kelykokutou/-STM32-/附加文件/大三_实训作业_智能家居控制.xlsx

Comment | Footprint | Quantity | Designator
button | switch_2P | 6 | B1, B2, B3, B4, B5, B6
20pF | 0603 | 2 | C1, C2
10nF | 0603 | 2 | C3, C9
100nF | 0603 | 10 | C4, C5, C6, C7, C11, C12, C13, C14, C15, C16
4.7uF | 0603 | 1 | C8
1uF | 0603 | 1 | C10
100uF | CAP_3.5_8mm | 1 | C17
Diode | SOD_123 | 5 | D1, D2, D3, D4, D5
LED | 0603-led | 4 | D6, D7, D8, D9
7.62_螺丝固定端子 |  | 1 | J6
继电器-5V | relay_5pin | 1 | K1
Header 4 | HDR1X4 | 2 | P1, P2
Header 2 | HDR1X2 | 2 | P3, P4
Header 2 | 2P_螺钉式接线端子_5.08mm | 1 | P5
Header 3 | HDR1X3 | 1 | P7
MOS_N | SOT-23 | 1 | Q1
3K3 | 0603 | 7 | R1, R2, R3, R4, R5, R6, R7
10K | 0603 | 1 | R8
1k | 0603 | 2 | R9, R10
5K | 0603 | 4 | R11, R12, R13, R14
ME6211 | SOT-23-5 | 1 | U2
BH1750 | BH1750 | 1 | U3
L293B | DIP16 | 1 | U4
STM32F101C6T6 | LQFP48_M | 1 | U5
8M | 5032 | 1 | Y1
跳线帽
跳线
ST_LINK
串口转换器
12832OLED屏幕
