kelykokutou/-STM32-/(list of files, drawings)

Other design files:
AD工程/大三_实训作业_智能家居控制/Sheet1.SchDoc
AD工程/大三_实训作业_智能家居控制/大三_实训作业_智能家居控制.PrjPcb
